yvtr/DigitalAudioRS485/Core/Src/main.c

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
/* Includes ------------------------------------------------------------------*/
#include "main.h"

/* USER CODE BEGIN Includes */
#include <ctype.h>
#include <stdint.h>
#include <string.h>

#include "disp7seg.h"
#include "gitinfo.h"
#include "printf.h"
#include "sounds.h"
#include "tlv320aic3104_ctrl.h"
#include "u8g2.h"
#include "usart2_dma.h"
#include "usart3_dma.h"
#include "uart5_it.h"
#include "ui.h"
#include "wavetable.h"

/* USER CODE END Includes */

/* USER CODE BEGIN PTD */

#define AUDIO_TX_CHAN_CNT           2     // Audio channel count for sending on RS485 bus
#define AUDIO_BUF_SAMPLE_CNT        512   // Audio buffer size in samples (per channel)

typedef struct {
   const DMA_TypeDef* dma;       // GPDMA instance (GPDMA1 or GPDMA2)
   uint32_t    dmaChannel;       // DMA channel used for this audio DAC
   uint32_t*   dmaBuf;           // DMA buffer for audio samples (32-bit words, left justified 16-bit samples in upper half, stereo interleaved)
   uint32_t    dmaBufSizeBytes;  // Size of DMA buffer in bytes
   uint32_t    dmaBufSampleCnt;  // Number of audio samples (per channel) in DMA buffer (dmaBufSizeBytes / 4 / 2)
   uint32_t    PrevSampleIdx;    // Previous sample index processed in DMA buffer, used to detect new samples for processing
   uint8_t     AudioChSel;       // Audio channel selection by user for this DAC

   uint32_t    Phase;
   uint32_t    PhaseInc;         // phase increment
   int16_t     IncDir;           // phase increment direction for modulation: -1 or +1

   int16_t  AudioChanBuf[AUDIO_BUF_SAMPLE_CNT];   // Audio sample buffer for each channel, filled by audio ADC task and consumed by RS485 bus task. Each sample is 16-bit signed integer.
   uint16_t AudioWrPos;   // Write position in audio buffer (in samples)
   uint16_t AudioRdPos;   // Read position in audio buffer (in samples)
   uint16_t AudioDatCnt;  // Number of valid audio samples in buffer (per channel)
   uint8_t  playing;      // flag indicating if audio is currently playing (1) or buffering (0)
} AudioDac;

/* USER CODE END PTD */

/* USER CODE BEGIN PD */
#define ARRAY_COUNT(arr) (sizeof(arr) / sizeof((arr)[0]))

/* USER CODE END PD */


LL_DMA_LinkNodeTypeDef Node_GPDMA2_Channel1;
LL_DMA_LinkNodeTypeDef Node_GPDMA2_Channel0;
LL_DMA_LinkNodeTypeDef Node_GPDMA2_Channel3;
LL_DMA_LinkNodeTypeDef Node_GPDMA2_Channel2;

LL_DMA_LinkNodeTypeDef Node_GPDMA1_Channel3;
LL_DMA_LinkNodeTypeDef Node_GPDMA1_Channel1;

/* USER CODE BEGIN PV */

#define I2S2_RXDMA_BUF_SAMPLE_CNT   512
#define I2S2_TXDMA_BUF_SAMPLE_CNT   512

uint32_t I2S2RxDmaBuf[I2S2_RXDMA_BUF_SAMPLE_CNT][2] = {0};
uint32_t I2S2TxDmaBuf[I2S2_TXDMA_BUF_SAMPLE_CNT][2] = {0};

#define I2S3_RXDMA_BUF_SAMPLE_CNT   512
#define I2S3_TXDMA_BUF_SAMPLE_CNT   512

uint32_t I2S3RxDmaBuf[I2S3_RXDMA_BUF_SAMPLE_CNT][2] = {0};
uint32_t I2S3TxDmaBuf[I2S3_TXDMA_BUF_SAMPLE_CNT][2] = {0};

AudioDac AudioDac_A = {GPDMA2, LL_DMA_CHANNEL_0, (uint32_t*)I2S2TxDmaBuf, sizeof(I2S2TxDmaBuf), I2S2_TXDMA_BUF_SAMPLE_CNT, 0, 3, 0, (4UL << 14), 1};
AudioDac AudioDac_B = {GPDMA2, LL_DMA_CHANNEL_2, (uint32_t*)I2S3TxDmaBuf, sizeof(I2S3TxDmaBuf), I2S3_TXDMA_BUF_SAMPLE_CNT, 0, 4, 0, (4UL << 14), 1};



uint8_t Vol = 0;

// Display instances for OLED LCD A and LCD B
static u8g2_t LcdA;
static u8g2_t LcdB;

/* USER CODE END PV */

void SystemClock_Config(void);
void PeriphCommonClock_Config(void);
static void MX_GPIO_Init(void);
static void MX_GPDMA1_Init(void);
static void MX_GPDMA2_Init(void);
static void MX_ICACHE_Init(void);
static void MX_TIM5_Init(void);
static void MX_TIM2_Init(void);
static void MX_USART3_UART_Init(void);
static void MX_UART5_Init(void);
static void MX_USART2_UART_Init(void);
static void MX_I2S2_Init(void);
static void MX_I2C1_Init(void);
static void MX_I2S3_Init(void);
static void MX_I2C3_Init(void);
static void MX_SPI1_Init(void);
/* USER CODE BEGIN 0 */
static inline void LD2_On()     { LL_GPIO_SetOutputPin(  SHR_DIN_KBD_LED_B_GPIO_Port, SHR_DIN_KBD_LED_B_Pin); }
static inline void LD2_Off()    { LL_GPIO_ResetOutputPin(SHR_DIN_KBD_LED_B_GPIO_Port, SHR_DIN_KBD_LED_B_Pin); }
static inline void LD2_Toggle() { LL_GPIO_TogglePin(     SHR_DIN_KBD_LED_B_GPIO_Port, SHR_DIN_KBD_LED_B_Pin); }

static inline void LCDA_CS_Deselect()   { LL_GPIO_SetOutputPin( LCDA_CS_GPIO_Port, LCDA_CS_Pin);   }
static inline void LCDA_CS_Select()     { LL_GPIO_ResetOutputPin( LCDA_CS_GPIO_Port, LCDA_CS_Pin); }

static inline void LCDB_CS_Deselect()   { LL_GPIO_SetOutputPin( LCDB_CS_GPIO_Port, LCDB_CS_Pin);   }
static inline void LCDB_CS_Select()     { LL_GPIO_ResetOutputPin( LCDB_CS_GPIO_Port, LCDB_CS_Pin); }

static inline void LCD_DC_High()        { LL_GPIO_SetOutputPin( LCD_DC_GPIO_Port, LCD_DC_Pin);   }
static inline void LCD_DC_Low()         { LL_GPIO_ResetOutputPin( LCD_DC_GPIO_Port, LCD_DC_Pin); }

static inline void LCD_RST_High()       { LL_GPIO_SetOutputPin( LCD_RST_GPIO_Port, LCD_RST_Pin);   }
static inline void LCD_RST_Low()        { LL_GPIO_ResetOutputPin( LCD_RST_GPIO_Port, LCD_RST_Pin); }

/***************************************************************************//**
 * @brief Check if specified time interval has elapsed
 * @param tref Pointer to time reference variable [ms]
 * @param tcycle Time interval in milliseconds
 *//****************************************************************************/
static inline uint32_t TickChk(uint32_t *tref, int_fast16_t tcycle) {
   uint32_t t = LL_TIM_GetCounter(TIM2) / 2;    // 2kHz/2=1kHz
   int32_t tdif = t - *tref;
   if (tdif >= tcycle) {
      *tref += tcycle;
      return 1;
   }
   return 0;
}

/***************************************************************************//**
* @brief Character send interface for printf function
*//****************************************************************************/
void uart_putc (void* p, char c) {
   Uart5_PutByte(c);
}

/***************************************************************************//**
* @brief Audio statistics
*//****************************************************************************/
void AudioStat(int16_t left, int16_t right) {
   static int32_t SumL = 0;
   static int32_t SumR = 0;
   static int16_t MinL = 0;
   static int16_t MaxL = 0;
   static int16_t MinR = 0;
   static int16_t MaxR = 0;
   SumL += left;
   SumR += right;
   if (left < MinL) MinL = left;
   if (left > MaxL) MaxL = left;
   if (right < MinR) MinR = right;
   if (right > MaxR) MaxR = right;
   static uint32_t PrintDelay = 0;
   if (++PrintDelay == 32000) {   // print every 32000 samples (approx every 1s at 32kHz sample rate)
      PrintDelay = 0;
      printf("A:%d,%d L(%d %d) R(%d %d)\n", SumL/32000, SumR/32000, MinL, MaxL, MinR, MaxR);
      SumL = 0;
      SumR = 0;
      MinL = INT16_MAX;
      MaxL = INT16_MIN;
      MinR = INT16_MAX;
      MaxR = INT16_MIN;
   }
}

/***************************************************************************//**
* @brief Process received data from USART2 (DMA rx callback)
*//****************************************************************************/
void ProcessUsart2RxData(const uint8_t* data, uint16_t len) {
}

/***************************************************************************//**
* @brief Process received data from USART3 (DMA rx callback)
*
* Decode audio packets received on USART3 (RS485 bus) and store audio samples
* in buffer for playback.
*
* Packet format [bytes]:
* [Header1]
* [Header2]
* [Channel]
* [Sample1_L]
* [Sample1_H]
* [Sample2_L]
* [Sample2_H]
* ...
* [SampleN_L]
* [SampleN_H]
*
*//****************************************************************************/
void ProcessUsart3RxData(const uint8_t* data, uint16_t len) {
#if 0
   static uint32_t ByteCnt = 0;
   static uint32_t SampleCnt = 0;
   ByteCnt += len;
   const uint16_t PacketSize = 3 + 128 * 2;  // Packet header (3 bytes) + 128 samples * 2 bytes per sample
   if (ByteCnt >= PacketSize) {
      ByteCnt -= PacketSize;
      SampleCnt += 128;
      if (SampleCnt >= 32000) {
         SampleCnt -= 32000;
         printf("AudioRx %u ms\n", usTimerGetAbs() / 1000); // Print timestamp every 32k samples (every 1 second at 32kHz sample rate)
      }
   }
#endif

   #define  DAT_IDX_START1       (-3)
   #define  DAT_IDX_START2       (DAT_IDX_START1 + 1)
   #define  DAT_IDX_CHANNEL      (DAT_IDX_START2 + 1)
   #define  AUDIO_PACKET_SIZE    256
   #define  AUDIO_CHANNELS       8

   #define  CIN_START1     111
   #define  CIN_START2     222

   static int16_t DatCnt = DAT_IDX_START1;
   static uint8_t ChanMatchA = 0;
   static uint8_t ChanMatchB = 0;
   static uint8_t LSB = 0;

   uint8_t ovfdiag = 1;
   for (size_t i=0; i<len; i++) {
      uint8_t d = data[i];
      switch (DatCnt) {
         case DAT_IDX_START1: {
            if (d == CIN_START1) DatCnt++;
         }break;
         case DAT_IDX_START2: {
            if (d == CIN_START2) DatCnt++;
            else DatCnt = DAT_IDX_START1;       // reset
         }break;
         case DAT_IDX_CHANNEL: {
            if (d < AUDIO_CHANNELS) {           // channel number range OK
               ChanMatchA = (d == AudioDac_A.AudioChSel) ? 1 : 0; // check channel number
               ChanMatchB = (d == AudioDac_B.AudioChSel) ? 1 : 0;
               DatCnt++;
               //printf("Ch%u\n", AudioChan);
            }else {                             // channel number out of range (invalid packet)
               DatCnt = DAT_IDX_START1;         // reset
            }
         }break;
         default: {
            if ((DatCnt & 1) == 0) {   // even index: LSByte
               LSB = d;                // store LSByte
            }else {                    // odd index: MSByte
               int16_t sample = ((uint16_t)d << 8) | LSB;   // combine MSByte and LSByte to form signed 16-bit audio sample
               //AudioStat(sample, 0);

               // Store received audio samples from RS485 to audio buffer
               if (ChanMatchA) {
                  AudioDac* d = &AudioDac_A;
                  if (d->AudioDatCnt < AUDIO_BUF_SAMPLE_CNT-1) {
                     d->AudioDatCnt++;
                     d->AudioWrPos++; // increment position
                     if (d->AudioWrPos >= AUDIO_BUF_SAMPLE_CNT) d->AudioWrPos = 0;  // wrap around if end of buffer reached
                     d->AudioChanBuf[d->AudioWrPos] = sample;     // store audio sample
                  }else {
                     if (ovfdiag) {
                        ovfdiag = 0;
                        printf("f");   // overflow
                     }
                  }
               }
               if (ChanMatchB) {
                  AudioDac* d = &AudioDac_B;
                  if (d->AudioDatCnt < AUDIO_BUF_SAMPLE_CNT-1) {
                     d->AudioDatCnt++;
                     d->AudioWrPos++; // increment position
                     if (d->AudioWrPos >= AUDIO_BUF_SAMPLE_CNT) d->AudioWrPos = 0;  // wrap around if end of buffer reached
                     d->AudioChanBuf[d->AudioWrPos] = sample;     // store audio sample
                  }else {
                     if (ovfdiag) {
                        ovfdiag = 0;
                        printf("F");   // overflow
                     }
                  }
               }
            }
            if (++DatCnt == AUDIO_PACKET_SIZE) DatCnt = DAT_IDX_START1; // done
         }break;
      }
   }

}


/***************************************************************************//**
* @brief  List specified registers of TLV320AIC3204 codec for debugging
*//****************************************************************************/
void TLV320_AIC3204_DumpRegs(void) {
   printf("TLV320_AIC3204: Dumping registers...\n");

   CODEC_SELECT    codec = CODEC_A;
   TLV_PAGE_SELECT page = TLV_PAGE_0;
   uint8_t         reg_list[] = { 0,2,3,4,5,6,7,8,9,10,11,47,51,43,37,44,64,65,38 };

   for (size_t i = 0; i < ARRAY_COUNT(reg_list); i++) {
      uint8_t reg = reg_list[i];
      int16_t val = TlvReadReg(codec, page, reg);
      printf("Reg %2u: 0x%02X (%d) \n", reg, val, val);
   }

   printf("TLV320_AIC3204: Dump done\n");
}

/***************************************************************************//**
* @brief   TLV320AIC3204 codec init with basic config for stereo playing (DAC)
*//****************************************************************************/
void TLV320_AIC3204_Init() {
   for (uint8_t codec = CODEC_A; codec <= CODEC_B; codec++) {
      TlvWriteReg(codec, TLV_PAGE_0,   3, 0x10);
      TlvWriteReg(codec, TLV_PAGE_0,   7, 0x0A);
      TlvWriteReg(codec, TLV_PAGE_0,   9, 0x10);
      TlvWriteReg(codec, TLV_PAGE_0,  47, 0x80);
      TlvWriteReg(codec, TLV_PAGE_0,  51, 0x09);
      TlvWriteReg(codec, TLV_PAGE_0,  43, 0x00);
      TlvWriteReg(codec, TLV_PAGE_0,  37, 0xD0);
      TlvWriteReg(codec, TLV_PAGE_0,  44, 0x00);
      TlvWriteReg(codec, TLV_PAGE_0,  64, 0x80);
      TlvWriteReg(codec, TLV_PAGE_0,  65, 0x09);
      TlvWriteReg(codec, TLV_PAGE_0,  38, 0x0C);
      TlvWriteReg(codec, TLV_PAGE_0, 101, 0x01);
      TlvWriteReg(codec, TLV_PAGE_0, 102, 0x02);

      TlvWriteReg(codec, TLV_PAGE_0,  15, 0x40);
      TlvWriteReg(codec, TLV_PAGE_0,  16, 0x40);
      TlvWriteReg(codec, TLV_PAGE_0,  17, 0xFF);
      TlvWriteReg(codec, TLV_PAGE_0,  18, 0xF0);
      TlvWriteReg(codec, TLV_PAGE_0,  19, 0x0D);
      TlvWriteReg(codec, TLV_PAGE_0,  21, 0x80);
      TlvWriteReg(codec, TLV_PAGE_0,  22, 0xFD);
      TlvWriteReg(codec, TLV_PAGE_0,  24, 0xF8);
      TlvWriteReg(codec, TLV_PAGE_0,  25, 0x80);
      TlvWriteReg(codec, TLV_PAGE_0,  40, 0xC1);
      TlvWriteReg(codec, TLV_PAGE_0,  41, 0x02);
      TlvWriteReg(codec, TLV_PAGE_0,  42, 0x88);
      TlvWriteReg(codec, TLV_PAGE_0,  46, 0x00);
      TlvWriteReg(codec, TLV_PAGE_0,  49, 0x00);
      TlvWriteReg(codec, TLV_PAGE_0,  50, 0x00);
      TlvWriteReg(codec, TLV_PAGE_0,  53, 0x00);
      TlvWriteReg(codec, TLV_PAGE_0,  54, 0x00);
      TlvWriteReg(codec, TLV_PAGE_0,  56, 0x00);
      TlvWriteReg(codec, TLV_PAGE_0,  57, 0x00);
      TlvWriteReg(codec, TLV_PAGE_0,  58, 0x01);
      TlvWriteReg(codec, TLV_PAGE_0,  60, 0x00);
      TlvWriteReg(codec, TLV_PAGE_0,  61, 0x00);
      TlvWriteReg(codec, TLV_PAGE_0,  63, 0x00);
      TlvWriteReg(codec, TLV_PAGE_0,  67, 0x00);
      TlvWriteReg(codec, TLV_PAGE_0,  68, 0x00);
      TlvWriteReg(codec, TLV_PAGE_0,  70, 0x00);
      TlvWriteReg(codec, TLV_PAGE_0,  71, 0x00);
      TlvWriteReg(codec, TLV_PAGE_0,  72, 0x01);
   }
}


void Fill_I2S_Buffer(AudioDac* dac, uint32_t start_sample, uint32_t sample_count) {
   uint_fast8_t doubling = 0;
   uint_fast8_t dropping = 0;

   for (uint32_t i = 0; i < sample_count; i++) {
      int16_t pcmsample = 0;

      switch (dac->AudioChSel) {
         case 9: {
            uint32_t frac = dac->Phase & 0x3FFF;        // fractional part for interpolation (14 bits)
            uint16_t idx  = dac->Phase >> 14;           // integer part: array index
            uint16_t idx2 = (idx + 1) % ARRAY_COUNT(Wave_Sin); // next index for linear interpolation
            int32_t pcm1 = Wave_Sin[idx];          // sine waveform
            int32_t pcm2 = Wave_Sin[idx2];         // next sample for interpolation
            pcmsample = pcm1 + ((pcm2 - pcm1) * frac >> 14); // linear interpolation
            pcmsample = pcmsample / 2;             // reduce amplitude
            dac->Phase = (dac->Phase + dac->PhaseInc) % (ARRAY_COUNT(Wave_Sin) << 14); // phase accumulator with wrap-around
            if (dac->AudioChSel == 5) dac->PhaseInc += dac->IncDir;  // Chsel: 6=fixed freq, 5=sweep up and down
            if (dac->PhaseInc < ( 4UL << 14)) dac->IncDir =  1; // minimum frequency reached, change direction to up
            if (dac->PhaseInc > (16UL << 14)) dac->IncDir = -1; // maximum frequency reached, change direction to down
         }break;
         case 7: {
            uint32_t frac = dac->Phase & 0x3FFF;        // fractional part for interpolation (14 bits)
            uint16_t idx  = dac->Phase >> 14;           // integer part: array index
            uint16_t idx2 = (idx + 1) % ARRAY_COUNT(Wave_Organ); // next index for linear interpolation
            int32_t pcm1 = Wave_Organ[idx];          // sine waveform
            int32_t pcm2 = Wave_Organ[idx2];         // next sample for interpolation
            pcmsample = pcm1 + ((pcm2 - pcm1) * frac >> 14); // linear interpolation
            pcmsample = pcmsample / 2;             // reduce amplitude
            dac->Phase = (dac->Phase + dac->PhaseInc) % (ARRAY_COUNT(Wave_Organ) << 14); // phase accumulator with wrap-around
            if (dac->AudioChSel == 7) dac->PhaseInc += dac->IncDir;  // Chsel: 3=fixed freq, 4=sweep up and down
            if (dac->PhaseInc < ( 4UL << 14)) dac->IncDir =  1; // minimum frequency reached, change direction to up
            if (dac->PhaseInc > (16UL << 14)) dac->IncDir = -1; // maximum frequency reached, change direction to down
         }break;

         case 6:
         case 5:
         case 4:
         case 3:
         case 2:
         case 1:
         case 0: {
            if (dac->AudioDatCnt < (AUDIO_BUF_SAMPLE_CNT * 1 / 8)) {    // too few samples in input buffer
               if (doubling == 0) doubling = 10;
            }
            if (dac->playing) {
               if (dac->AudioDatCnt == 0) {    // no samples to play
                  pcmsample = 0;          // mute output
                  dac->playing = 0;       // stop playing until buffer is refilled
                  printf("x");
               } else {
                  int16_t d = dac->AudioChanBuf[dac->AudioRdPos];  // read audio sample
                  pcmsample = d;                         // normal playback
                  dac->AudioDatCnt--;
                  dac->AudioRdPos++;
                  if (dac->AudioRdPos >= AUDIO_BUF_SAMPLE_CNT) dac->AudioRdPos = 0;
               }
            } else {    // Buffering (wait..)
               pcmsample = 0;
               if (dac->AudioDatCnt > (AUDIO_BUF_SAMPLE_CNT / 2)) {
                  dac->playing = 1;
                  printf("w");
               }
            }
            if (dac->AudioDatCnt > (AUDIO_BUF_SAMPLE_CNT * 7 / 8)) { // too many samples in input buffer
               if (dropping == 0) dropping = 10;
            }
         }break;
      }
      int32_t frame = pcmsample << 16; // convert to 32-bit sample with 16-bit left justified
      uint32_t pos = (start_sample + i) * 2;  // Stereo: L,R
      dac->dmaBuf[pos + 0] = frame/4;   // Left
      dac->dmaBuf[pos + 1] = frame/4;   // Right

      if (doubling == 10) {
         if (i<sample_count-1) {
            int32_t frame = pcmsample << 16; // convert to 32-bit sample with 16-bit left justified
            uint32_t pos = (start_sample + i) * 2;  // Stereo: L,R
            dac->dmaBuf[pos + 0] = frame/4;   // Left (duplicate sample)
            dac->dmaBuf[pos + 1] = frame/4;   // Right
            i++;
            if (dac->playing) printf("+");
         }
      }
      if (doubling) doubling--;

      if (dropping == 5) {
         dac->AudioDatCnt--;
         dac->AudioRdPos++;  // drop sample (no output for this sample)
         if (dac->AudioRdPos >= AUDIO_BUF_SAMPLE_CNT) dac->AudioRdPos = 0;
         if (dac->playing) printf("-");
      }
      if (dropping) dropping--;

   }
}

void AudioDAC_Task(AudioDac* dac) {
   uint32_t dma_ptr = dac->dmaBufSizeBytes - LL_DMA_GetBlkDataLength(dac->dma, dac->dmaChannel);
   uint32_t sample_idx = dma_ptr / 8; // Word = 4 bytes * 2 channels = 8 bytes per sample

   if (sample_idx != dac->PrevSampleIdx) {
      uint32_t free_samples;
      if (sample_idx > dac->PrevSampleIdx) {
         free_samples = sample_idx - dac->PrevSampleIdx;         // normal case: DMA is in between old and new index
         Fill_I2S_Buffer(dac, dac->PrevSampleIdx, free_samples);
      } else {
         free_samples = dac->dmaBufSampleCnt - dac->PrevSampleIdx;   // Wrap-around
         Fill_I2S_Buffer(dac, dac->PrevSampleIdx, free_samples);     // first the rest until end of buffer
         if (sample_idx > 0) {
            Fill_I2S_Buffer(dac, 0, sample_idx);
         }
      }

      dac->PrevSampleIdx = sample_idx;
   }
   //printf("dma_ptr:%u dma_word_index:%u sample_index:%u\n", dma_ptr, dma_word_index, sample_index);
}

void Proc_I2S_Buffer(uint32_t *buf, uint32_t start_sample, uint32_t sample_count) {
   enum { BUFCNT = 7 };
   static uint8_t Buf[BUFCNT][512];
   // Create audio packets from received I2S samples and send on USART2 (RS485 bus)
   for (uint32_t i = 0; i < sample_count; i++) {
      uint32_t pos = (start_sample + i) * 2;  // Stereo: L,R
      int16_t left  = buf[pos + 0] >> 16;   // convert back to 16-bit sample from 32-bit left justified
      int16_t right = buf[pos + 1] >> 16;   // convert back to 16-bit sample from 32-bit left justified
      {
         static uint16_t ByteTxIdx = 0;   // byte index for filling audio packet buffer
         static uint16_t SampleTxIdx = 0; // index for counting audio samples in current packet
         static uint32_t PcmPos = 0;      // position in PCM sample stream [samples]
         static uint32_t Phase = 0;       // phase accumulator for sine wave generation
         static const uint32_t PhaseInc = (4UL << 14) + 2345;  // phase increment for sine wave generation (controls frequency)
         if (SampleTxIdx == 0) {          // start of new packet, fill header
            ByteTxIdx = 0;
            for (int b=0; b<BUFCNT; b++) Buf[b][ByteTxIdx] = CIN_START1; // Packet header byte 1
            ByteTxIdx++;
            for (int b=0; b<BUFCNT; b++) Buf[b][ByteTxIdx] = CIN_START2; // Packet header byte 2
            ByteTxIdx++;
            for (int b=0; b<BUFCNT; b++) Buf[b][ByteTxIdx] = b;          // channel number
            ByteTxIdx++;
         }
         enum { AUDIO_PACKET_HDR_SIZE   = 3   };   // header size in bytes
         enum { AUDIO_PACKET_SAMPLE_CNT = 128 };   // number of audio samples in one packet
         if (SampleTxIdx < AUDIO_PACKET_SAMPLE_CNT) {
            PcmPos++;   // increment position in PCM sample stream
            if (PcmPos > (PCM_DolmetscheranlageLen + 2*32000)
            &&  PcmPos > (PCM_InterpreterSystemLen + 2*32000)
            &&  PcmPos > (PCM_TolmacsrendszerLen   + 2*32000)
            ) {
               PcmPos = 0;
            }
            int16_t s_de = PCM_Dolmetscheranlage[PcmPos];
            int16_t s_en = PCM_InterpreterSystem[PcmPos];
            int16_t s_hu = PCM_Tolmacsrendszer[PcmPos];
            if (PcmPos >= PCM_DolmetscheranlageLen) s_de = 0;
            if (PcmPos >= PCM_InterpreterSystemLen) s_en = 0;
            if (PcmPos >= PCM_TolmacsrendszerLen)   s_hu = 0;

            uint32_t frac = Phase & 0x3FFF;        // fractional part for interpolation (14 bits)
            uint16_t idx  = Phase >> 14;           // integer part: array index
            uint16_t idx2 = (idx + 1) % ARRAY_COUNT(Wave_Sin); // next index for linear interpolation
            int32_t pcm1 = Wave_Sin[idx];          // sine waveform
            int32_t pcm2 = Wave_Sin[idx2];         // next sample for interpolation
            int16_t s_sin = pcm1 + ((pcm2 - pcm1) * frac >> 14); // linear interpolation
            s_sin = s_sin / 2;             // reduce amplitude
            Phase = (Phase + PhaseInc) % (ARRAY_COUNT(Wave_Sin) << 14); // phase accumulator with wrap-around

            // Low byte of 16 bit audio sample
            Buf[0][ByteTxIdx] = left & 0xFF;   // store low byte of audio sample in packet buffer
            Buf[1][ByteTxIdx] = right & 0xFF;
            Buf[2][ByteTxIdx] = s_de & 0xFF;
            Buf[3][ByteTxIdx] = s_en & 0xFF;
            Buf[4][ByteTxIdx] = s_hu & 0xFF;
            Buf[5][ByteTxIdx] = 0;
            Buf[6][ByteTxIdx] = s_sin & 0xFF;
            ByteTxIdx++;

            // High byte of 16 bit audio sample
            Buf[0][ByteTxIdx] = left >> 8;     // store high byte of audio sample in packet buffer
            Buf[1][ByteTxIdx] = right >> 8;
            Buf[2][ByteTxIdx] = s_de >> 8;
            Buf[3][ByteTxIdx] = s_en >> 8;
            Buf[4][ByteTxIdx] = s_hu >> 8;
            Buf[5][ByteTxIdx] = 0;
            Buf[6][ByteTxIdx] = s_sin >> 8;
            ByteTxIdx++;
            SampleTxIdx++;
         }
         if (SampleTxIdx == AUDIO_PACKET_SAMPLE_CNT) {         // packet is full, send it
            Usart2_TxBufWrite(Buf[0], ByteTxIdx, 0);   // write packet to USART2 DMA buffer
            Usart2_TxBufWrite(Buf[1], ByteTxIdx, 0);   // write packet to USART2 DMA buffer
            Usart2_TxBufWrite(Buf[2], ByteTxIdx, 0);   // write packet to USART2 DMA buffer
            Usart2_TxBufWrite(Buf[3], ByteTxIdx, 0);   // write packet to USART2 DMA buffer
            Usart2_TxBufWrite(Buf[4], ByteTxIdx, 0);   // write packet to USART2 DMA buffer
            Usart2_TxBufWrite(Buf[5], ByteTxIdx, 0);   // write packet to USART2 DMA buffer
            Usart2_TxBufWrite(Buf[6], ByteTxIdx, 1);   // write packet to USART2 DMA buffer and flush (start transfer)
            ByteTxIdx = 0;    // reset byte index for next packet
            SampleTxIdx = 0;  // reset sample index for next packet
         }
      }
      AudioStat(left, right);
   }
}

void AudioADC_Task(void) {
   static uint32_t old_sample_index = 0;
   // DMA pointer --> Word-Index
   uint32_t dma_ptr = sizeof(I2S2RxDmaBuf) - LL_DMA_GetBlkDataLength(GPDMA2, LL_DMA_CHANNEL_1);
   uint32_t sample_index = dma_ptr / 8; // Word = 4 bytes * 2 channels = 8 bytes per sample

   if (sample_index != old_sample_index) {
      uint32_t free_samples;
      if (sample_index > old_sample_index) {
         free_samples = sample_index - old_sample_index;         // normal case: DMA is in between old and new index
         Proc_I2S_Buffer(I2S2RxDmaBuf[0], old_sample_index, free_samples);
      } else {
         free_samples = I2S2_RXDMA_BUF_SAMPLE_CNT - old_sample_index;         // Wrap-around
         Proc_I2S_Buffer(I2S2RxDmaBuf[0], old_sample_index, free_samples); // first the rest until end of buffer
         if (sample_index > 0) {
            Proc_I2S_Buffer(I2S2RxDmaBuf[0], 0, sample_index);
         }
      }

      old_sample_index = sample_index;
   }
   //printf("dma_ptr:%u dma_word_index:%u sample_index:%u\n", dma_ptr, dma_word_index, sample_index);
}

/***************************************************************************//**
* @brief  Handle keyboard input and update state
*//****************************************************************************/
static inline void Kbd_Task(void) {
   static uint32_t KbdPrev = 0;
   uint32_t k = Kbd_ReadState();
   uint32_t pressed =   k & ~KbdPrev;  // newly pressed keys
   uint32_t released = ~k &  KbdPrev;  // newly released keys
   for (uint16_t i=0; pressed | released; i++) {
      if (pressed & 1) {
         UI_EventProcKbd(i);                    // key pressed
      }
      if (released & 1) {
         UI_EventProcKbd(i + 256);              // key released
      }
      pressed >>= 1;
      released >>= 1;
   }
   KbdPrev = k;
}

void AudioSetChannelA(uint8_t chan) { AudioDac_A.AudioChSel = chan; }
void AudioSetChannelB(uint8_t chan) { AudioDac_B.AudioChSel = chan; }


/***************************************************************************//**
* @brief  GPIO and delay callback for u8g2 library (LCD-A control)
*//****************************************************************************/
uint8_t u8x8_stm32_gpio_and_delay_LcdA(U8X8_UNUSED u8x8_t *u8x8, U8X8_UNUSED uint8_t msg, U8X8_UNUSED uint8_t arg_int, U8X8_UNUSED void *arg_ptr) {
   switch (msg) {
   case U8X8_MSG_GPIO_AND_DELAY_INIT:
      LL_mDelay(1);
      break;
   case U8X8_MSG_DELAY_MILLI:
      LL_mDelay(arg_int);
      break;
   case U8X8_MSG_GPIO_CS:
      if (arg_int) LCDA_CS_Deselect();
      else         LCDA_CS_Select();
      break;
   case U8X8_MSG_GPIO_DC:
      if (arg_int) LCD_DC_High();
      else         LCD_DC_Low();
      break;
   case U8X8_MSG_GPIO_RESET:
      if (arg_int) LCD_RST_High();
      else         LCD_RST_Low();
      break;
   }
   return 1;
}

/***************************************************************************//**
* @brief  GPIO and delay callback for u8g2 library (LCD-B control)
*//****************************************************************************/
uint8_t u8x8_stm32_gpio_and_delay_LcdB(U8X8_UNUSED u8x8_t *u8x8, U8X8_UNUSED uint8_t msg, U8X8_UNUSED uint8_t arg_int, U8X8_UNUSED void *arg_ptr) {
   switch (msg) {
   case U8X8_MSG_GPIO_AND_DELAY_INIT:
      LL_mDelay(1);
      break;
   case U8X8_MSG_DELAY_MILLI:
      LL_mDelay(arg_int);
      break;
   case U8X8_MSG_GPIO_CS:
      if (arg_int) LCDB_CS_Deselect();
      else         LCDB_CS_Select();
      break;
   case U8X8_MSG_GPIO_DC:
      if (arg_int) LCD_DC_High();
      else         LCD_DC_Low();
      break;
   case U8X8_MSG_GPIO_RESET:
      // Shared reset pin for both LCDs, handled in LcdA callback
      // Initialization order: first LcdA, then LcdB!
      // Resetting in LcdA callback will reset both LCDs
      break;
   }
   return 1;
}

/***************************************************************************//**
* @brief  Byte-level communication callback for u8g2 library (4-wire hardware SPI)
*//****************************************************************************/
uint8_t u8x8_byte_4wire_hw_spi(u8x8_t *u8x8, uint8_t msg, uint8_t arg_int, void *arg_ptr) {
   switch (msg) {
   case U8X8_MSG_BYTE_SEND:
      uint8_t* dat = (uint8_t*)arg_ptr;
      for (uint16_t i = 0; i < arg_int; i++) {
         while (!LL_SPI_IsActiveFlag_TXP(SPI1)); // wait until transmit FIFO has space
         LL_SPI_TransmitData8(SPI1, dat[i]);
      }
      while (!LL_SPI_IsActiveFlag_TXC(SPI1)); // Ensure the last byte has been physically transmitted (wait for TXC)
      break;
   case U8X8_MSG_BYTE_INIT:
      u8x8_gpio_SetCS(u8x8, u8x8->display_info->chip_disable_level);
      break;
   case U8X8_MSG_BYTE_SET_DC:
      u8x8_gpio_SetDC(u8x8, arg_int);
      break;
   case U8X8_MSG_BYTE_START_TRANSFER:
      LL_SPI_Enable(SPI1);
      LL_SPI_StartMasterTransfer(SPI1);
      u8x8_gpio_SetCS(u8x8, u8x8->display_info->chip_enable_level);
      break;
   case U8X8_MSG_BYTE_END_TRANSFER:
      u8x8_gpio_SetCS(u8x8, u8x8->display_info->chip_disable_level);
      LL_SPI_ClearFlag_TXTF(SPI1);
      LL_SPI_Disable(SPI1);
      break;
   default:
      return 0;
   }
   return 1;
}


/* USER CODE END 0 */

/**
  * @brief  The application entry point.
  * @retval int
  */
int main(void)
{

  /* MCU Configuration--------------------------------------------------------*/

  /* Reset of all peripherals, Initializes the Flash interface and the Systick. */

  /* System interrupt init*/
  NVIC_SetPriorityGrouping(NVIC_PRIORITYGROUP_4);

  /* SysTick_IRQn interrupt configuration */
  NVIC_SetPriority(SysTick_IRQn, NVIC_EncodePriority(NVIC_GetPriorityGrouping(),15, 0));

  /* Configure the system clock */
  SystemClock_Config();

  /* Configure the peripherals common clocks */
  PeriphCommonClock_Config();

  /* USER CODE BEGIN SysInit */

   for (uint32_t i = 0; i < I2S2_TXDMA_BUF_SAMPLE_CNT; i++) {
      int32_t a = INT32_MAX / 2 * sin(2 * 3.14159265358979323846 * i / I2S2_TXDMA_BUF_SAMPLE_CNT); // sine wave
      int32_t b = INT32_MAX / 2 * sin(4 * 3.14159265358979323846 * i / I2S2_TXDMA_BUF_SAMPLE_CNT); // sine wave at 2x frequency
      I2S2TxDmaBuf[i][0] = a; // left channel sample
      I2S2TxDmaBuf[i][1] = b; // right channel sample

      // I2S3 (Codec-B)
      I2S3TxDmaBuf[i][0] = a; // left channel sample
      I2S3TxDmaBuf[i][1] = b; // right channel sample
   }

  /* USER CODE END SysInit */

  /* Initialize all configured peripherals */
  MX_GPIO_Init();
  MX_GPDMA1_Init();
  MX_GPDMA2_Init();
  MX_ICACHE_Init();
  MX_TIM5_Init();
  MX_TIM2_Init();
  MX_USART3_UART_Init();
  MX_UART5_Init();
  MX_USART2_UART_Init();
  MX_I2S2_Init();
  MX_I2C1_Init();
  MX_I2S3_Init();
  MX_I2C3_Init();
  MX_SPI1_Init();
  /* USER CODE BEGIN 2 */

  CODEC_RST_LO();    // Reset the audio codec via HW reset pin
  __NOP();
  __NOP();
  CODEC_RST_HI();

  init_printf(NULL, &uart_putc);

  LL_TIM_GenerateEvent_UPDATE(TIM2);
  LL_TIM_EnableCounter(TIM2);
  LL_TIM_GenerateEvent_UPDATE(TIM5);
  LL_TIM_EnableCounter(TIM5);

  LL_Init1msTick(SystemCoreClock);

  DispPutDigit(0, ' ', 0);
  DispPutDigit(1, ' ', 0);
  DispPutDigit(2, ' ', 0);
  DispPutDigit(3, ' ', 0);
  ShiftReg_Update();

  Usart2_DMA_Init(ProcessUsart2RxData);
  Usart3_DMA_Init(ProcessUsart3RxData);
  Uart5_Init();

  TLV320_AIC3204_Init();

   u8g2_Setup_sh1106_128x64_noname_f(&LcdA, U8G2_R0, u8x8_byte_4wire_hw_spi, u8x8_stm32_gpio_and_delay_LcdA);
   u8g2_Setup_sh1106_128x64_noname_f(&LcdB, U8G2_R0, u8x8_byte_4wire_hw_spi, u8x8_stm32_gpio_and_delay_LcdB);
   u8g2_InitDisplay(&LcdA);
   u8g2_InitDisplay(&LcdB);
   u8g2_SetPowerSave(&LcdA, 0);
   u8g2_SetPowerSave(&LcdB, 0);

   char s[64];
   u8g2_ClearBuffer(&LcdA);
   u8g2_ClearBuffer(&LcdB);
   u8g2_DrawFrame(&LcdA, 0, 0, 128, 64);   // frame
   u8g2_DrawFrame(&LcdB, 0, 0, 128, 64);   // frame
   u8g2_SetFont(&LcdA, u8g2_font_8x13B_tf);
   u8g2_SetFont(&LcdB, u8g2_font_8x13B_tf);
   sprintf(s, "Digital Audio");
   u8g2_DrawStr(&LcdA, 12, 20, s);      // title
   u8g2_DrawStr(&LcdB, 12, 20, s);      // title
   u8g2_SetFont(&LcdA, u8g2_font_6x10_tf);
   u8g2_SetFont(&LcdB, u8g2_font_6x10_tf);
   sprintf(s, "Software: v0.3");
   u8g2_DrawStr(&LcdA, 6, 36, s);
   u8g2_DrawStr(&LcdB, 6, 36, s);
   sprintf(s, "Git: %s", Git_VersionStr, Git_BranchStr);
   u8g2_DrawStr(&LcdA, 6, 46, s);
   u8g2_DrawStr(&LcdB, 6, 46, s);
   sprintf(s, "Date: %04u-%02u-%02u", Git_DateYear, Git_DateMonth, Git_DateDay);
   u8g2_DrawStr(&LcdA, 6, 56, s);
   u8g2_DrawStr(&LcdB, 6, 56, s);
   u8g2_SendBuffer(&LcdA); // transfer buffer content to LCD
   u8g2_SendBuffer(&LcdB); // transfer buffer content to LCD

   printf("----------------------------------------\n"
      "Digital Audio\n"
      "Git version: %s (%s)\n"
      "----------------------------------------\n",
      Git_VersionStr,
      Git_BranchStr
   );

  UI_Init();

  /* USER CODE END 2 */

  /* Infinite loop */
  /* USER CODE BEGIN WHILE */
   while (1)
   {
      static uint32_t Tick10msRef = 0;
      if (TickChk(&Tick10msRef, 10)) {  // execute every 10ms
         ShiftReg_Update();
         Kbd_Task();  // handle keyboard input and update state
         UI_EventProc(EV_UI_TICK_10MS);
      }

      static uint32_t Tick1secRef = 0;
      if (TickChk(&Tick1secRef, 1000)) {  // execute every 1s
         LD2_Toggle();
         UI_EventProc(EV_UI_TICK_1S);
         static uint8_t cnt = 0;
         cnt = (cnt + 1) % 8;
      }

      static uint32_t Tick100msRef = 0;
      if (TickChk(&Tick100msRef, 100)) {  // execute every 100ms
      }

      int16_t ch = Uart5_GetByte();
      if (ch != -1) {  // if data received
         char c = ch;
         static uint8_t PGA = 64;
         if (c == 'a') {
            printf("I2S RX buf:\n");
            for (size_t i = 0; i < I2S2_RXDMA_BUF_SAMPLE_CNT; i++) {
               printf("%d;%d\n", I2S2RxDmaBuf[i][0]/65536, I2S2RxDmaBuf[i][1]/65536);
            }
         } else if (c == ' ') {
            uint8_t d = 255;
            Usart2_TxBufWrite(&d, 1, 1);  // send trigger byte on USART2 to start ping-pong test
         } else if (c == 'd') {
            TLV320_AIC3204_DumpRegs();
         }else if (c == 'u') {
            if (PGA < 127-8) {
               PGA += 8;
               TlvWriteReg(CODEC_A, TLV_PAGE_0, 15, PGA);  // PGA_L
               TlvWriteReg(CODEC_A, TLV_PAGE_0, 16, PGA);  // PGA_R
               printf("PGA: %u\n", PGA);
            }
         }else if (c == 'j') {
            if (PGA >= 8) {
               PGA -= 8;
               TlvWriteReg(CODEC_A, TLV_PAGE_0, 15, PGA);  // PGA_L
               TlvWriteReg(CODEC_A, TLV_PAGE_0, 16, PGA);  // PGA_R
               printf("PGA: %u\n", PGA);
            }
         }else if (c == 't') { UI_EventProcKbd(0);
         }else if (c == 'z') { UI_EventProcKbd(1);
         }else if (c == 'h') { UI_EventProcKbd(2);
         }else if (c == 'o') { UI_EventProcKbd(3);
         }else if (c == 'i') { UI_EventProcKbd(4);
         }else if (c == 'k') { UI_EventProcKbd(5);
         }else if (c == 'f') {
            TlvWriteReg(CODEC_A, TLV_PAGE_0, 12, 0xF0);  // Enable ADC high-pass filter
         }
      }

      Usart2_DMA_Task(); // handle USART2 DMA rx/tx
      Usart3_DMA_Task(); // handle USART3 DMA rx/tx
      AudioDAC_Task(&AudioDac_A);  // handle audio data processing for Codec-A (I2S2)
      AudioDAC_Task(&AudioDac_B);  // handle audio data processing for Codec-B (I2S3)
      AudioADC_Task();      // handle audio data processing from I2S Rx buffer
      UI_CheckEvent();


    /* USER CODE END WHILE */

    /* USER CODE BEGIN 3 */
  }
  /* USER CODE END 3 */
}

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
