yvtr/DigitalAudioRS485/Core/Inc/main.h

#define KBDA_RIGHT_UP_Pin LL_GPIO_PIN_13
#define KBDA_RIGHT_UP_GPIO_Port GPIOC
#define SHR_CLK_Pin LL_GPIO_PIN_14
#define SHR_CLK_GPIO_Port GPIOC
#define SHR_STR_Pin LL_GPIO_PIN_15
#define SHR_STR_GPIO_Port GPIOC
#define KBDA_LEFT_UP_Pin LL_GPIO_PIN_0
#define KBDA_LEFT_UP_GPIO_Port GPIOC
#define KBDA_RIGHT_DOWN_Pin LL_GPIO_PIN_3
#define KBDA_RIGHT_DOWN_GPIO_Port GPIOC
#define CODEC_RST_Pin LL_GPIO_PIN_0
#define CODEC_RST_GPIO_Port GPIOA
#define LCDA_CS_Pin LL_GPIO_PIN_4
#define LCDA_CS_GPIO_Port GPIOC
#define LCDB_CS_Pin LL_GPIO_PIN_5
#define LCDB_CS_GPIO_Port GPIOC
#define LCD_RST_Pin LL_GPIO_PIN_0
#define LCD_RST_GPIO_Port GPIOB
#define LCD_DC_Pin LL_GPIO_PIN_2
#define LCD_DC_GPIO_Port GPIOB
#define KBDB_LEFT_UP_Pin LL_GPIO_PIN_8
#define KBDB_LEFT_UP_GPIO_Port GPIOC
#define SHR_DIN_KBD_LED_B_Pin LL_GPIO_PIN_10
#define SHR_DIN_KBD_LED_B_GPIO_Port GPIOA
#define KBDB_RIGHT_UP_Pin LL_GPIO_PIN_11
#define KBDB_RIGHT_UP_GPIO_Port GPIOC
#define KBDB_LEFT_DOWN_Pin LL_GPIO_PIN_3
#define KBDB_LEFT_DOWN_GPIO_Port GPIOB
#define SHR_DOUT_DISP_Pin LL_GPIO_PIN_8
#define SHR_DOUT_DISP_GPIO_Port GPIOB
#define NVIC_PRIORITYGROUP_0         ((uint32_t)0x00000007) /*!< 0 bit  for pre-emption priority,
#define NVIC_PRIORITYGROUP_1         ((uint32_t)0x00000006) /*!< 1 bit  for pre-emption priority,
#define NVIC_PRIORITYGROUP_2         ((uint32_t)0x00000005) /*!< 2 bits for pre-emption priority,
#define NVIC_PRIORITYGROUP_3         ((uint32_t)0x00000004) /*!< 3 bits for pre-emption priority,
#define NVIC_PRIORITYGROUP_4         ((uint32_t)0x00000003) /*!< 4 bits for pre-emption priority,
#define SHR_COUNT    4
