yvtr/DigitalAudioRS485/Core/Inc/wavetable.h

/***************************************************************************//**
* Copyright (c) 2026 Unicod
*
* Licensed under the Apache License, Version 2.0 (the "License");
* you may not use this file except in compliance with the License.
* You may obtain a copy of the License at
*
*     http://www.apache.org/licenses/LICENSE-2.0
*
* Unless required by applicable law or agreed to in writing, software
* distributed under the License is distributed on an "AS IS" BASIS,
* WITHOUT WARRANTIES OR CONDITIONS OF ANY KIND, either express or implied.
* See the License for the specific language governing permissions and
* limitations under the License.
*******************************************************************************/

#ifndef __WAVETABLE_H__
#define __WAVETABLE_H__

static const int16_t Wave_Sin[1024] = {
          0,      201,      402,      603,      804,     1005,     1206,     1406,     1607,     1808,
       2009,     2209,     2410,     2610,     2811,     3011,     3211,     3411,     3611,     3811,
       4011,     4210,     4409,     4608,     4807,     5006,     5205,     5403,     5601,     5799,
       5997,     6195,     6392,     6589,     6786,     6982,     7179,     7375,     7571,     7766,
       7961,     8156,     8351,     8545,     8739,     8932,     9126,     9319,     9511,     9703,
       9895,    10087,    10278,    10469,    10659,    10849,    11038,    11227,    11416,    11604,
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
   ,5712
   ,6224
   ,6735
   ,7244
   ,7750
   ,8255
   ,8757
   ,9257
   ,9753
   ,10248
   ,10739
   ,11227
   ,11712
   ,12194
   ,12672
   ,13147
   ,13618
   ,14086
   ,14549
   ,15008
   ,15463
   ,15914
   ,16361
   ,16803
   ,17240
   ,17672
   ,18100
   ,18523
   ,18940
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
};

#endif
