yvtr/DigitalAudioRS485/Core/Inc/gitinfo.h

#ifndef __GITINFO_H__
#define __GITINFO_H__

#include <stdint.h>


extern const uint16_t Git_BuildNr;
extern const uint32_t Git_Hash32;
extern const char     Git_HashStr[];
extern const char     Git_BranchStr[];
extern const char     Git_VersionStr[];
extern const uint16_t Git_DateYear;
extern const uint8_t  Git_DateMonth;
extern const uint8_t  Git_DateDay;
extern const uint8_t  Git_DateHour;
extern const uint8_t  Git_DateMin;
extern const uint8_t  Git_DateSec;


#endif
