yvtr/DigitalAudioRS485/Core/Src/gitinfo.c

#include <stdint.h>


#include "gitdefs.h"
#include "gitinfo.h"


#ifndef GIT_HASH_HEX
#define GIT_HASH_HEX 0x00000000
#endif

#ifndef GIT_HASH_STR
#warning Missing Git commit info
#define GIT_HASH_STR "00000000"
#endif

#ifndef GIT_BRANCH_STR
#warning Missing Git branch info
#define GIT_BRANCH_STR  "unknown-branch"
#endif

#ifndef GIT_VERSION_STR
#warning Missing version info
#define GIT_VERSION_STR  "unknown-version"
#endif

#ifndef GIT_BUILD_NR
#warning Missing build number
#define GIT_BUILD_NR  0
#endif

const uint16_t Git_BuildNr      = GIT_BUILD_NR;
const uint32_t Git_Hash32       = GIT_HASH_HEX;
const char     Git_HashStr[]    = GIT_HASH_STR;
const char     Git_BranchStr[]  = GIT_BRANCH_STR;
const char     Git_VersionStr[] = GIT_VERSION_STR;
const uint16_t Git_DateYear     = GIT_DATE_YEAR;
const uint8_t  Git_DateMonth    = GIT_DATE_MONTH;
const uint8_t  Git_DateDay      = GIT_DATE_DAY;
const uint8_t  Git_DateHour     = GIT_DATE_HOUR;
const uint8_t  Git_DateMin      = GIT_DATE_MIN;
const uint8_t  Git_DateSec      = GIT_DATE_SEC;
