yvtr/DigitalAudioRS485/(commit log)

2026-02-23 Blinking LED on PC11
    - systick init: 1ms (no interrupt)
2026-02-23 TIM5: free running timer with [us] resolution
    - usTimerGetAbs
    - usTimerGetRel
    - Delay_us
2026-02-23 Added interrupt driven UART5
    - 115200 baud
    - TX: PC12
    - RX: PD2
    - clk: PLL3Q 32MHz
2026-02-23 printf targeted to UART5
2026-02-23 Builin printf replaced by lightweight variante
    [main.c, printf.c, printf.h]
2026-02-23 UART5 TX INT handler fix
    [uart5_it.c]
2026-02-23 USART3 DMA RX/TX works
    - Rx/Tx handler in usart3_dma.*
    - CubeMX: USART and DMA init
    - DMA CH0: Tx
    - DMA CH1: Rx
    - DMA Port0 for periph transfer
    - DMA Port1 for mem transfer
    - Continuous Rx handling via DMA pointer (no INT, no TC flag)
    - Tx: collect data into tx buf or send immediately
2026-02-23 USART2 DMA RX/TX works
    - Rx/Tx handler in usart2_dma.*
    - DMA CH2: Tx
    - DMA CH3: Rx
    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
2026-02-24 I2S2 TX circular DMA works
    - DMA: I2S TX (DAC)
    - I2S buffer: 256 samples (L+R)
    - sample width: 32 bit
    - audio data: sine wave (2x freq on right ch)
2026-02-24 GPDMA: interrupts disabled
2026-02-24 I2C1 enabled via CubeMX (LL)
    - PCLK: 32MHz (PLL3R)
    - 100kHz
    - no INT
    - SCL: PB6
    - SDA: PB7
2026-02-24 GPIO init for codec reset pin, reset pulse on system start
    [DigitalAudioH533.ioc, main.c, main.h]
2026-02-27 UART5 fix, big TX buffer for large listing
    [uart5_it.c, uart5_it_cfg.h]
2026-02-27 Added i2c_master.*
    - I2C_Write
    - I2C_Read
    - I2C_ReadReg
2026-03-10 TLV320: basic init for ADC and audio input
    - ADC on
    - Left ch: MIC1R max gain preamp (0dB)
    - Right ch: MIC2R max gain preamp (0dB)
    - PGA-L: +32dB
    - PGA-R: +32dB
2026-03-10 Audio_Task (sound player)
    - added sound (8-bit signed samples)
    - AudioTask: sound player with Fill_I2S_Buffer function
2026-03-10 I2S2 RX DMA
    - I2S RX DMA enabled in CubeMX
    - fixed CubeMX code (src+dest addr, len)
    TODO: config DMA node src/dest/len after CubeMX code
    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
    [DigitalAudioH533.ioc, main.c]
2026-03-10 AudioADC_Task: processing received ADC data
2026-03-10 ADC gain: PGA setting test
2026-03-11 ADC >> AudioBuf >> DAC forwarding works (mic signal to headphone)
    - Sound select: 7=mic (ADC right)
    - producer-consumer clock skew correction via sample doubling/dropping
    - keeping audio buffer between 25-75% fill level
    [main.c]
2026-03-14 RS485 5MBps ping-pong test, if Bus1 and Bus2 connected
    - baudrate: 5Mbps
    - UART2 sends 0..127
    - UART3 sends 128..255
    - 127 triggers sending 128..255
    - 255 triggers sending 0..127
2026-03-17 I2S3 DMA RX+TX
    - Added I2S3RxDmaBuf/I2S3TxDmaBuf
    - Tx buffer initialized by sine wave
    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
    [DigitalAudioH533.ioc, main.c]
2026-03-17 I2C3 enabled via CubeMX (LL)
    - SCL: PA8
    - SDA: PC9
    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
2026-03-20 DAC objects for playing on both codec
    - TODO replace static variables
    - TODO fix: codec-B louder, noise even if muted
    [main.c]
2026-04-17 AudioADC_Task DMA ptr calc fixed
    [main.c]
2026-04-17 Send single audio channel on RS485
    - Packet: header + 128 audio samples
    - Send on UART2
    - Uart3 Rx: counting samples, print tstamp on every 32k samples
2026-05-08 print stats for audio input data (mic1+mic2)
    - update rate: 1s
    - avg L/R
    - min/max of L/R sample values
2026-05-09 Send 7 audio channels
    - Datarate: 7 * 32k*2*10 * 259/256 = 4.53Mbps
    - Channels: mic1+2,DE,EN,HU,silence,sine
    - USART2 TX DMA buffer increased
2026-05-09 Volume key handling: write DAC volume registers
    - 0: muted
    - 1..16: DAC vol:-40dB..0dB, HPout level:0dB (normal range)
    - 17..20: DAC vol:0dB, HPout level: +2..+8dB (extra volume)
    TODO: 4 I2C transfers are too long, they makes glitch in audio stream
    [ui.c]
2026-05-11 Rev2: key pin modification
    - KBDA_RIGHT_UP: PA5 --> PC13
    - KBDA_RIGHT_DOWN: PA6 --> PC3
2026-05-11 SPI1 enabled for OLED display
    - SPI master transmit only (SCK+MOSI)
    - SPI main clk: PLL1Q (32MHz)
    - SPI bit clk: 4MHz (presc: 8)
    - PA5: SPI1_SCK
    - PA7: SPI1_MOSI
    - Code: LL lib
2026-05-15 Added script to generate git information macros
    - print git version on startup
2026-05-15 Added u8g2 LCD library, SH1106 4-wire SPI 128x64
    - Two LCD: shared SPI
    - hardware SPI1 (4MHz SCLK)
    - shared DC, RST pins
    - Separate CS pins: LCDA_CS, LCDB_CS
    - Display git info on startup
2026-05-15 Buffer sizes increased to prevent audio glitches at LCD update
    - volume set command makes still small glitches
    - TODO: split volume command into shorter parts
    [main.c, usart2_dma_cfg.h, usart3_dma_cfg.h]
